Zebra-Rodeo/marelleo/boitier/README.fr.md

# Le boitier

[English](README.md) · **Français**

Trois pieces, PLA, imprimees sur une Bambu Lab A1.

| Fichier | Taille | Reglages |
|---|---|---|
| `marelleo-corps.stl` | 120 x 120 x 80 mm | face ouverte vers le haut, aucun support |
| `marelleo-base.stl` | 120 x 120 x 29 mm | a plat |
| `marelleo-molette.stl` | 24 x 24 x 12 mm | a plat, 100 % de remplissage |

Buse 0,4 mm, couches de 0,2 mm, trois parois, 15 % de remplissage.

Le cercle grave sur le dessus dit ou poser la figurine, parce que l'antenne du
lecteur NFC est juste dessous. Sa portee traverse sans difficulte 3 mm de PLA.

**Inserts en laiton M3**, pas de vis autoforeuses. Visser dans du plastique
imprime tient une fois ou deux, puis la matiere se fend le long des couches.
L'insert se pose sur le trou, on vient dessus avec la panne du fer a souder, le
laiton chauffe, fond le plastique autour de lui et s'y noie. En refroidissant,
on a un pas de vis metal pris dans la piece.

Le modele a ete dessine sur Fusion 360 en licence loisir, qui est gratuite.
