Zebra-Rodeo/marelleo/boitier/README.md

# The enclosure

**English** · [Français](README.fr.md)

Three parts, PLA, printed on a Bambu Lab A1.

| File | Size | Settings |
|---|---|---|
| `marelleo-corps.stl` | 120 × 120 × 80 mm | open face up, no supports |
| `marelleo-base.stl` | 120 × 120 × 29 mm | flat |
| `marelleo-molette.stl` | 24 × 24 × 12 mm | flat, 100 % infill |

0.4 mm nozzle, 0.2 mm layers, three walls, 15 % infill.

The circle engraved on the top says where to put the figurine, because the NFC
reader's antenna is right underneath. Its range goes through 3 mm of PLA
without difficulty.

**M3 brass inserts**, not self-tapping screws. Screwing into printed plastic
holds once or twice, then the material splits along the layers. The insert
goes on the hole, you come down on it with the tip of the soldering iron, the
brass heats up, melts the plastic around itself and sinks in. As it cools you
have a metal thread captured in the part.

The model was drawn in Fusion 360 on the free hobbyist licence.
