Zebra-Rodeo/marelleo/carte/apercu-dessous.png

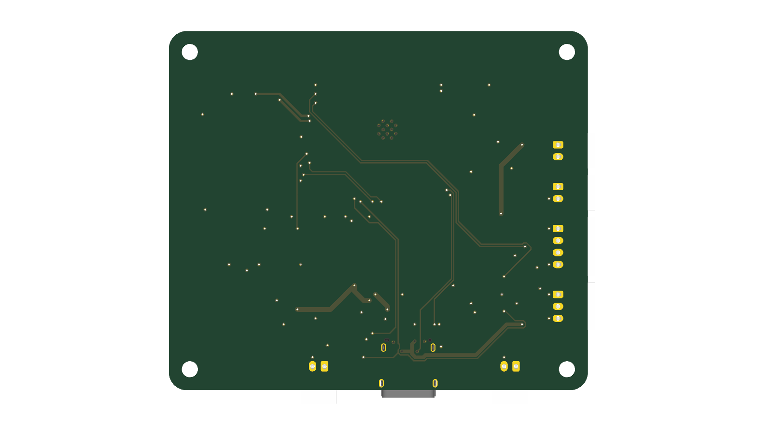
carte/apercu-dessous.png
