Zebra-Rodeo/marelleo/carte/fab/marelleo-bom.csv

Comment | Designator | Footprint | LCSC Part #
22uF 25V X5R 0805 | C1,C2,C4 | C_0805_2012Metric | C45783
10uF 25V X5R 0805 | C3,C6,C7,C8,C10 | C_0805_2012Metric | C15850
100nF 50V X7R 0603 | C5,C9,C12 | C_0603_1608Metric | C14663
470uF 10V 6.3x7.7 | C11 | CP_Elec_6.3x7.7 | C82004
1uF 50V X5R 0603 | C13 | C_0603_1608Metric | C15849
SS34 40V 3A | D1 | D_SMA | C8678
USB-C 24 contacts | J1 | USB_C_Receptacle_Amphenol_12401610E4-2A | C5119948
JST PH 4 broches coude | J2 | JST_PH_S4B-PH-K_1x04_P2.00mm_Horizontal | C157926
JST PH 2 broches coude | J3,J5,J6,J8 | JST_PH_S2B-PH-K_1x02_P2.00mm_Horizontal | C173752
JST PH 3 broches coude | J4 | JST_PH_S3B-PH-K_1x03_P2.00mm_Horizontal | C157929
microSD Hirose DM3AT-SF-PEJM5 | J7 | microSD_HC_Hirose_DM3AT-SF-PEJM5 | C114218
4.7uH 2A SLW4030S4R7MST | L1,L2 | L_Taiyo-Yuden_MD-4040 | C206284
2N7002 | Q1 | SOT-23 | C8545
75k | R1 | R_0603_1608Metric | C23242
10k | R2,R9,R16,R17,R18 | R_0603_1608Metric | C25804
100k | R3,R6,R10,R11,R19 | R_0603_1608Metric | C25803
0R | R4 | R_0603_1608Metric | C21189
1k | R7 | R_0603_1608Metric | C21190
1.5k | R8 | R_0603_1608Metric | C22843
1M | R12 | R_0603_1608Metric | C22935
5.1k | R14,R15 | R_0603_1608Metric | C23186
ESP32-S3-WROOM-1-N8R2 | U1 | ESP32-S3-WROOM-1 | C2913204
BQ24075RGTR | U2 | VQFN-16-1EP_3x3mm_P0.5mm_EP1.1x1.1mm | C15464
AP63203WU-7 | U3 | TSOT-23-6 | C780769
MT3608 | U4 | SOT-23-6 | C84817
MAX98357AETE+T | U5 | TQFN-16-1EP_3x3mm_P0.5mm_EP1.23x1.23mm | C910544
