Zebra-Rodeo/marelleo/boitier/marelleo-base.stl

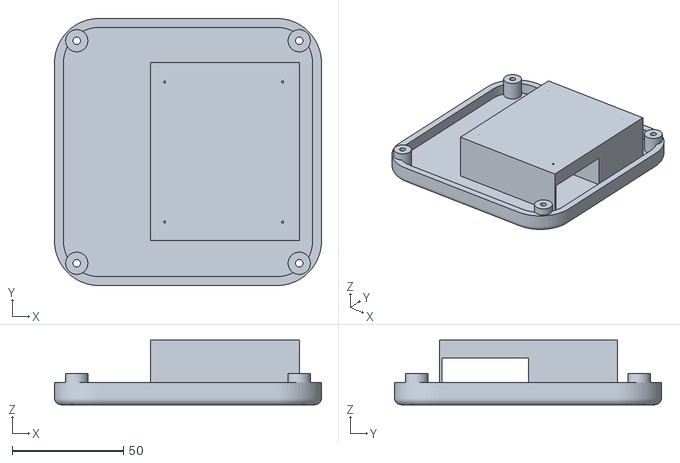
[picture p7: CAD file, 2026-10-16]
boitier/marelleo-base.stl
120.0 x 120.0 x 29.0
