Zebra-Rodeo/marelleo/boitier/marelleo-molette.stl

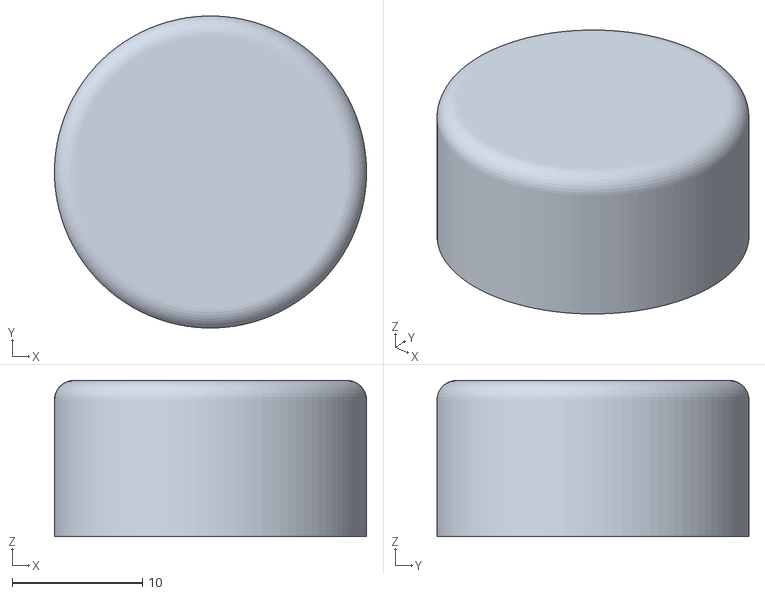
[picture p8: CAD file, 2026-10-16]
boitier/marelleo-molette.stl
24.0 x 24.0 x 12.0
