Zebra-Rodeo/marelleo/boitier/marelleo-corps.stl

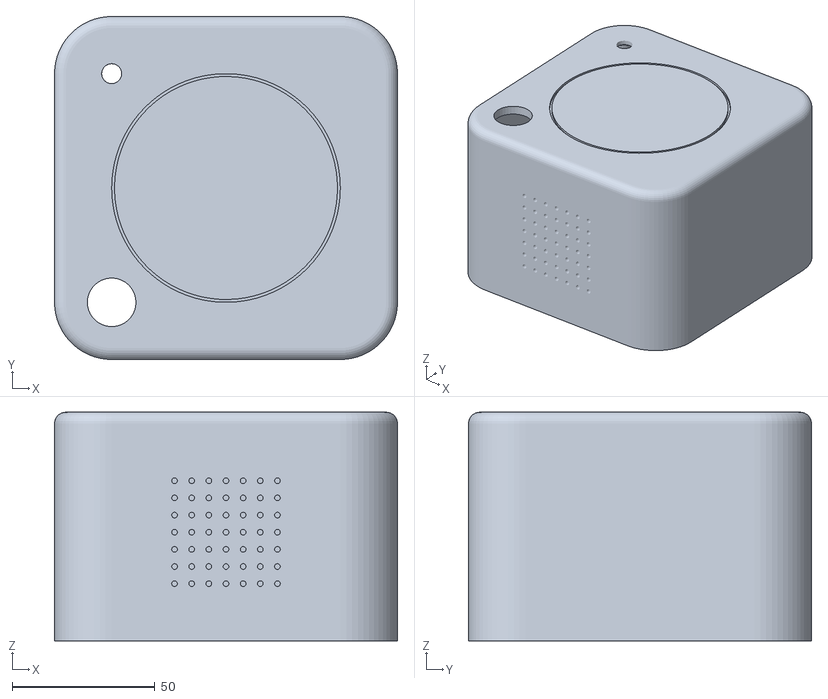
[picture p9: CAD file, 2026-10-16]
boitier/marelleo-corps.stl
120.0 x 120.0 x 80.0
