Zebra-Rodeo/marelleo/carte/marelleo.kicad_pcb

## KiCad design carte/marelleo.kicad_pcb (2026-10-16)

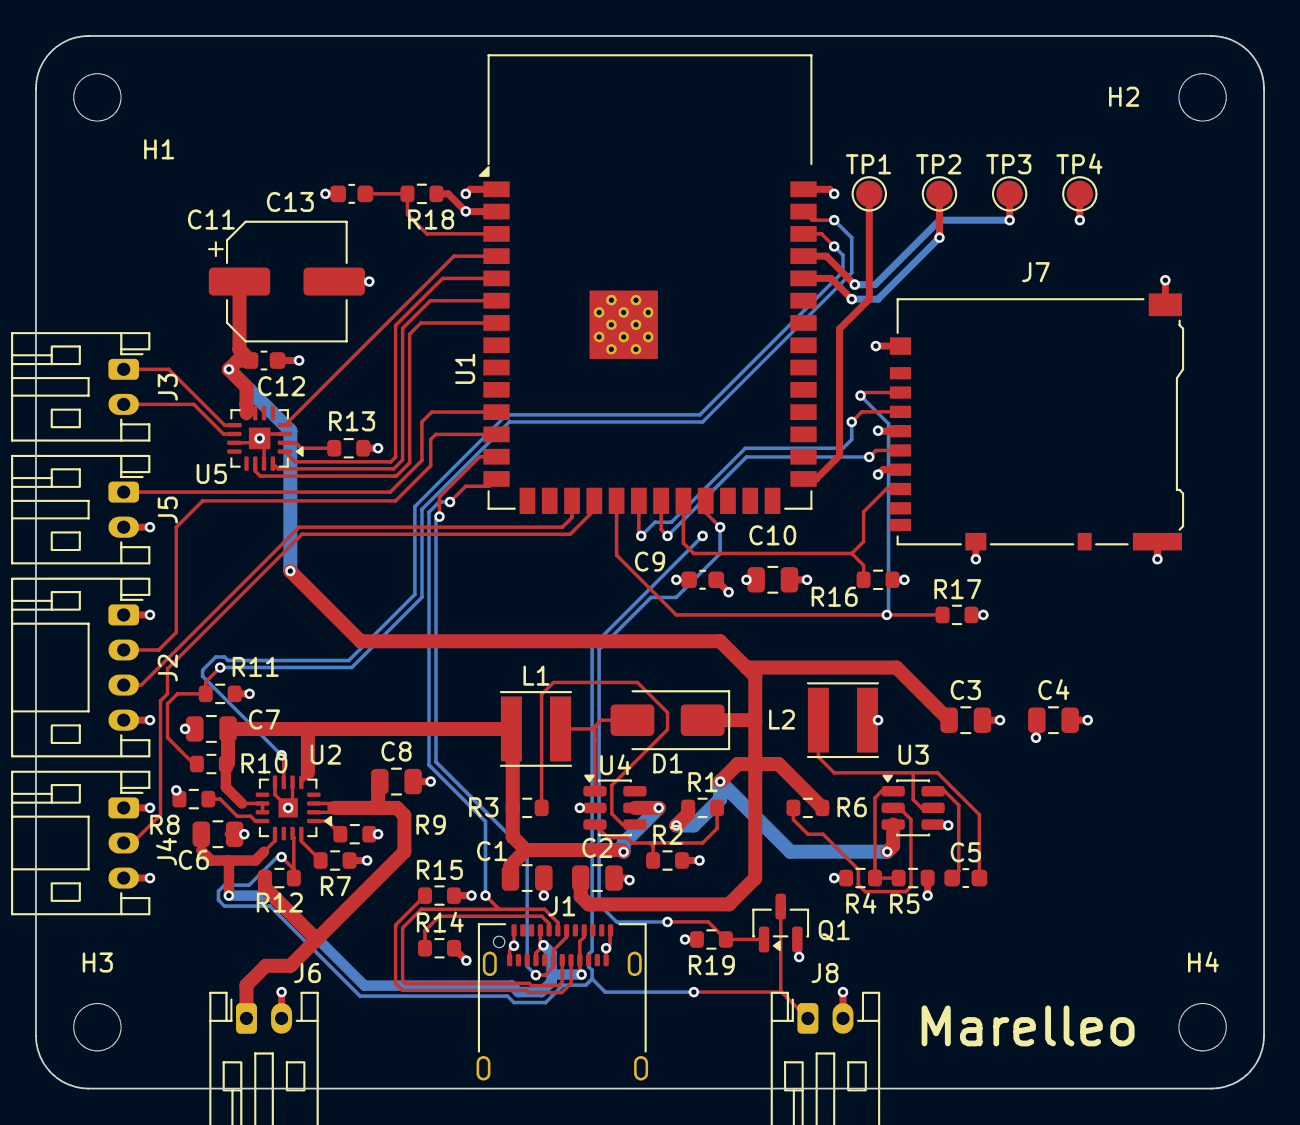
[picture p10: board marelleo.kicad_pcb from above]

Board: 4 copper layers, 70.0 x 60.0 mm, 57 parts (0 on the bottom side), 43 nets.

Parts:
C1, C2, C4: 22 uF; C_0805_2012Metric
C3, C6, C7, C8, C10: 10 uF; C_0805_2012Metric
C5, C9, C12: 100 nF; C_0603_1608Metric
C11: 470 uF; CP_Elec_6.3x7.7
C13: 1 uF; C_0603_1608Metric
D1: SS34; D_SMA
H1, H2, H3, H4: M2.5; MountingHole_2.7mm_M2.5
J1: USB-C, charge et mise a jour; USB_C_Receptacle_Amphenol_12401610E4-2A
J2: vers le lecteur NFC deporte; JST_PH_S4B-PH-K_1x04_P2.00mm_Horizontal
J3: haut-parleurs; JST_PH_S2B-PH-K_1x02_P2.00mm_Horizontal
J4: potentiometre de volume; JST_PH_S3B-PH-K_1x03_P2.00mm_Horizontal
J5: bouton; JST_PH_S2B-PH-K_1x02_P2.00mm_Horizontal
J6: batterie; JST_PH_S2B-PH-K_1x02_P2.00mm_Horizontal
J7: connecteur microSD; microSD_HC_Hirose_DM3AT-SF-PEJM5
J8: interrupteur du potentiometre; JST_PH_S2B-PH-K_1x02_P2.00mm_Horizontal
L1, L2: 4,7 uH; L_Taiyo-Yuden_MD-4040
Q1: 2N7002; SOT-23
R1: 75 k; R_0603_1608Metric
R2, R9, R16, R17, R18: 10 k; R_0603_1608Metric
R3, R6, R10, R11, R19: 100 k; R_0603_1608Metric
R4: 0 R; R_0603_1608Metric
R5, R13: NP; R_0603_1608Metric
R7: 1 k; R_0603_1608Metric
R8: 1,5 k; R_0603_1608Metric
R12: 1 M; R_0603_1608Metric
R14, R15: 5,1 k; R_0603_1608Metric
TP1: TEST_IO0; TestPoint_Pad_D1.5mm
TP2: TEST_RX; TestPoint_Pad_D1.5mm
TP3: TEST_TX; TestPoint_Pad_D1.5mm
TP4: GND; TestPoint_Pad_D1.5mm
U1: ESP32-S3-WROOM-1-N8R2; ESP32-S3-WROOM-1
U2: BQ24075RGT, chargeur a chemin d'alimentation; VQFN-16-1EP_3x3mm_P0.5mm_EP1.1x1.1mm
U3: AP63203WU, abaisseur 3V3; TSOT-23-6
U4: MT3608, elevateur 5V; SOT-23-6
U5: MAX98357A; TQFN-16-1EP_3x3mm_P0.5mm_EP1.23x1.23mm

Connections:
+3V3: C4.1, C9.1, C10.1, J2.1, J4.1, J7.4, L2.2, R4.1, R16.2, R17.2, R18.2, U1.2
+5V: C2.1, C3.1, C11.1, C12.1, D1.1, R1.1, R6.2, U3.3, U5.7, U5.8
AMPLI_ARRET: U1.4, U5.4
AMPLI_GAIN: R13.1, U5.2
ARRET: J8.1, Q1.3, R12.1, U2.15
ARRET_CMD: Q1.1, R19.1, U1.23
BOUTON: J5.1, U1.11
BST_3V3: C5.1, U3.6
EN_3V3: R6.1, U3.2
EN_5V: R3.1, U4.4
FB_3V3: R4.2, R5.1, U3.1
FB_5V: R1.2, R2.1, U4.3
GND: C1.2, C2.2, C3.2, C4.2, C6.2, C7.2, C8.2, C9.2, C10.2, C11.2, C12.2, C13.2, J1.A1, J1.A12, J1.B1, J1.B12, J1.SH, J2.4, J4.3, J5.2, J6.2, J7.6, J7.SH, J8.2, Q1.2, R2.2, R5.2, R7.2, R8.2, R9.2, R11.2, R13.2, R14.2, R15.2, R19.2, TP4.1, U1.1, U1.40, U1.41, U2.6, U2.8, U2.17, U3.4, U4.2, U5.3, U5.11, U5.15, U5.17
HP_MOINS: J3.2, U5.10
HP_PLUS: J3.1, U5.9
I2S_BCLK: U1.6, U5.16
I2S_DIN: U1.5, U5.1
I2S_LRCLK: U1.7, U5.14
ILIM: R8.1, U2.12
ISET: R7.1, U2.16
NFC_RX: J2.2, U1.12
NFC_TX: J2.3, U1.17
NIVEAU_BATTERIE: R10.2, R11.1, U1.39
RESET: C13.1, R18.1, U1.3
SD_CLK: J7.5, U1.21
SD_CS: J7.2, R17.1, U1.19
SD_MISO: J7.7, R16.1, U1.22
SD_MOSI: J7.3, U1.20
SW_3V3: C5.2, L2.1, U3.5
SW_5V: D1.2, L1.2, U4.1
TEST_IO0: TP1.1, U1.27
TEST_RX: TP2.1, U1.36
TEST_TX: TP3.1, U1.37
TS: R9.1, U2.1
USB_CC1: J1.A5, R14.1
USB_CC2: J1.B5, R15.1
USB_D+: J1.A6, J1.B6, U1.14
USB_D-: J1.A7, J1.B7, U1.13
USB_PRESENT: U1.38, U2.7
VBAT: C8.1, J6.1, R12.2, U2.2, U2.3
VBUS: C6.1, J1.A4, J1.A9, J1.B4, J1.B9, U2.13
VOLUME: J4.2, U1.18
VSYS: C1.1, C7.1, L1.1, R3.2, R10.1, U2.5, U2.10, U2.11, U4.5
