Zebra-Rodeo/marelleo/(commit log)

2026-10-16 Marelleo, de quoi la refaire
    Le boitier a imprimer, les fichiers de fabrication de la carte, le code du
    micrologiciel, et une doc qui part de zero : quoi acheter, dans quel ordre s'y
    prendre, et les pieges qui ont coute des soirees.
    Le port serie n'est plus fige dans platformio.ini, et le depot ne porte ni
    identifiants WiFi ni fichiers audio.
    Claude-Session: https://claude.ai/code/session_015okbtFBb8ae9fNXuosxdgM
2026-10-16 Dire que le micrologiciel est ecrit pour ce montage-la
    Le brochage vit dans le code, pas dans un fichier de reglage. Quelqu'un qui
    cable autrement et flashe tel quel obtient une boite qui ne marche pas, et pas
    toujours bruyamment : lecteur NFC muet, carte SD introuvable. Autant le dire
    avant, avec l'endroit ou changer les constantes.
    Et dire aussi que c'est un projet du dimanche qui tourne sur un echantillon
    d'une boite, pas une reference.
    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
2026-10-27 La documentation passe en anglais, le français reste à côté
    L'anglais devient la version par défaut, celle que GitHub affiche et que
    cherche quelqu'un qui tombe sur le dépôt. Le français garde tout, sous
    `.fr.md`, et chaque fichier porte en tête le lien vers son jumeau.
    Cinq documents traduits en entier, pas seulement le README : le micrologiciel,
    le boîtier, la carte, et les notes de conception, qui sont les vingt-deux
    kilo-octets où vivent les mesures au banc et les pièges.
    Les noms de dossiers et de fichiers ne bougent pas. `boitier`, `carte`,
    `marelleo-corps.stl` sont des identifiants, pas de la prose, et les renommer
    casserait les liens déjà partagés sans rien apprendre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
